conte91/MakeMeFly/README.md

This is a Programmable magnetic levitation project for my Electronics for embedded system course @Polythecnic University of Torino.

Follow my blog http://tux4u.wordpress.com for news about the project!
