conte91/MakeMeFly/Report/report.tex

\documentclass{article}
\newcommand{\pre}[1]{\texttt{#1}}
\usepackage{pdfpages}
\usepackage{graphicx}
\begin{document}
\includepdf{Copertina}
\include{0-intro}
\include{1-control}
\include{2-ADC}
\include{3-Coil}
\include{4-mouse}
\include{5-Flash}
\include{6-software}
\include{7-power}
\include{8-conclusions}
\end{document}
