conte91/MakeMeFly/Report/Copertina.odt

Simone Baratta

Electronics for embedded systems

A.A. 2013/2014

Magnetic levitation with a single Hall-effect sensor

Politecnico di Torino

Sept. 2015
