conte91/MakeMeFly/Plotter/green-button.png

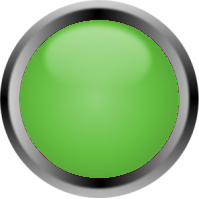
Plotter/green-button.png
