conte91/MakeMeFly/Plotter/red-button.png

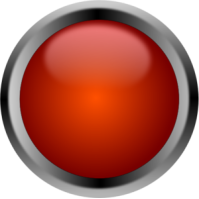
Plotter/red-button.png
