conte91/MakeMeFly/Report/Graphics/cpld_impl.png

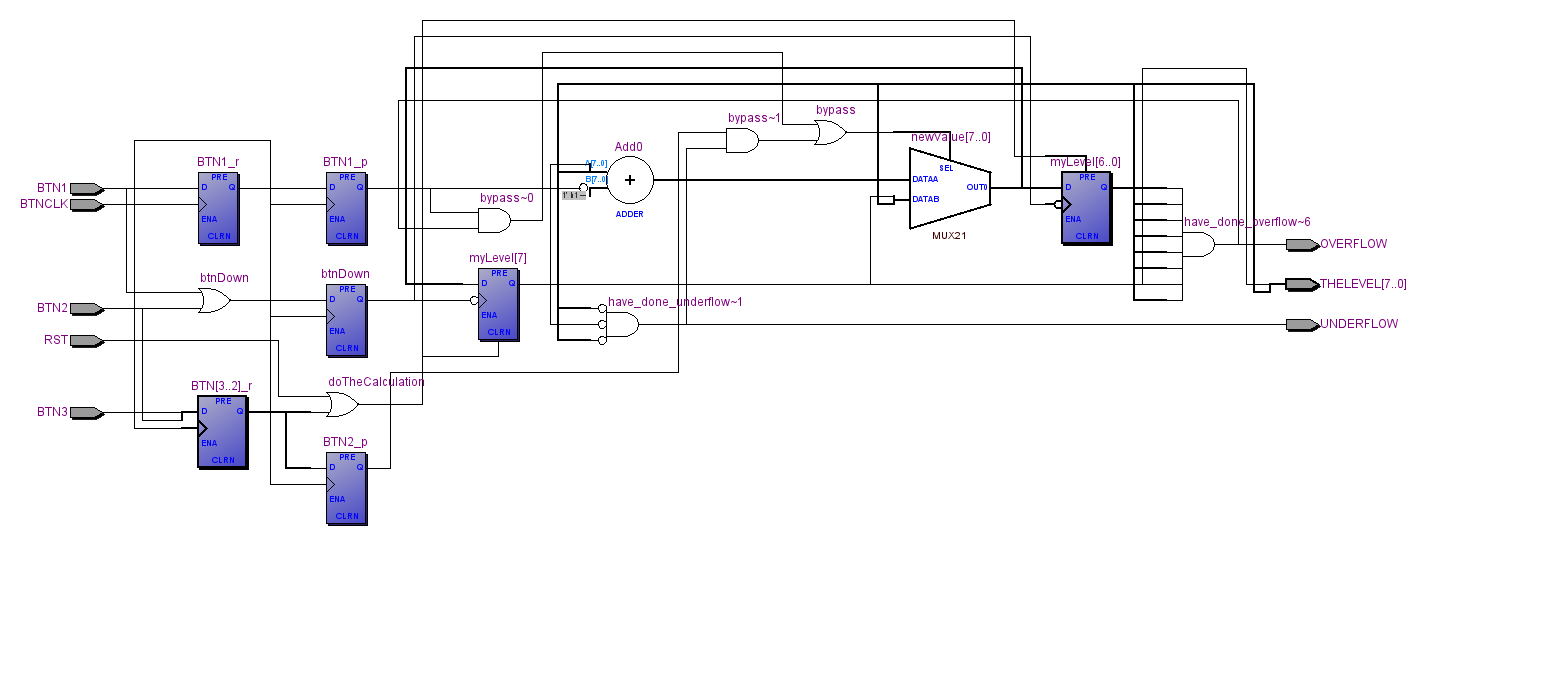
Report/Graphics/cpld_impl.png
