conte91/MakeMeFly/Plotter/test.pdf

### 5 mils 8 mils 12 mils 20 mils 35 mils 8 mils 12 mils 20 mils 35 mils

200 mils

10 sec | 15 sec | 20 sec | 25 sec | 30 sec | 40 sec | 50 sec | 60 sec | 80 sec | 100 sec | 120 sec | 150 sec | 180 sec | 240 sec
