conte91/MakeMeFly/Results/ADC_test/misctest.png

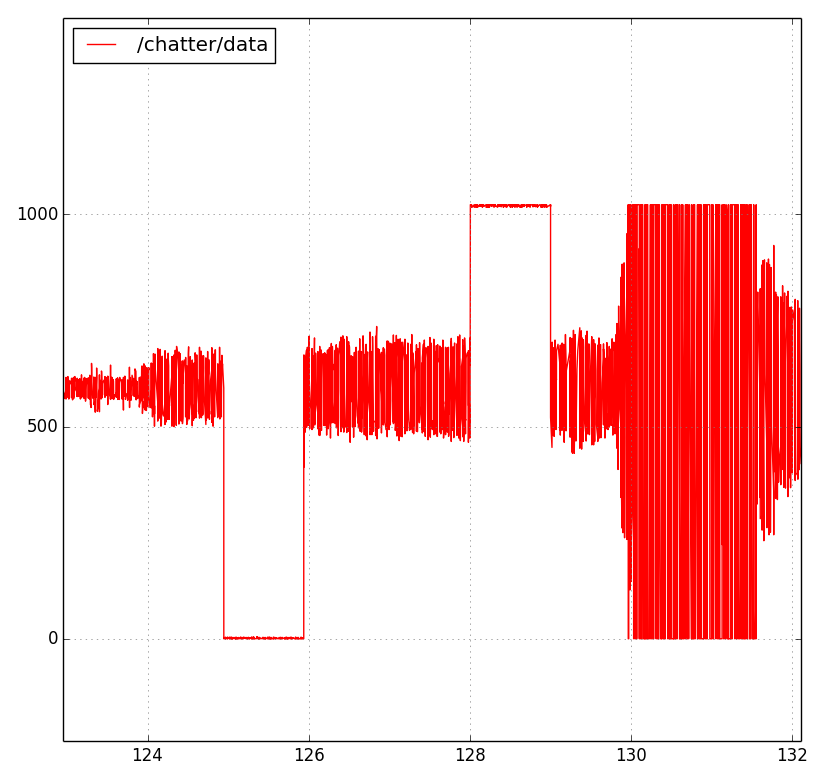
Results/ADC_test/misctest.png
