conte91/MakeMeFly/Results/ADC_test/whitenoise.png

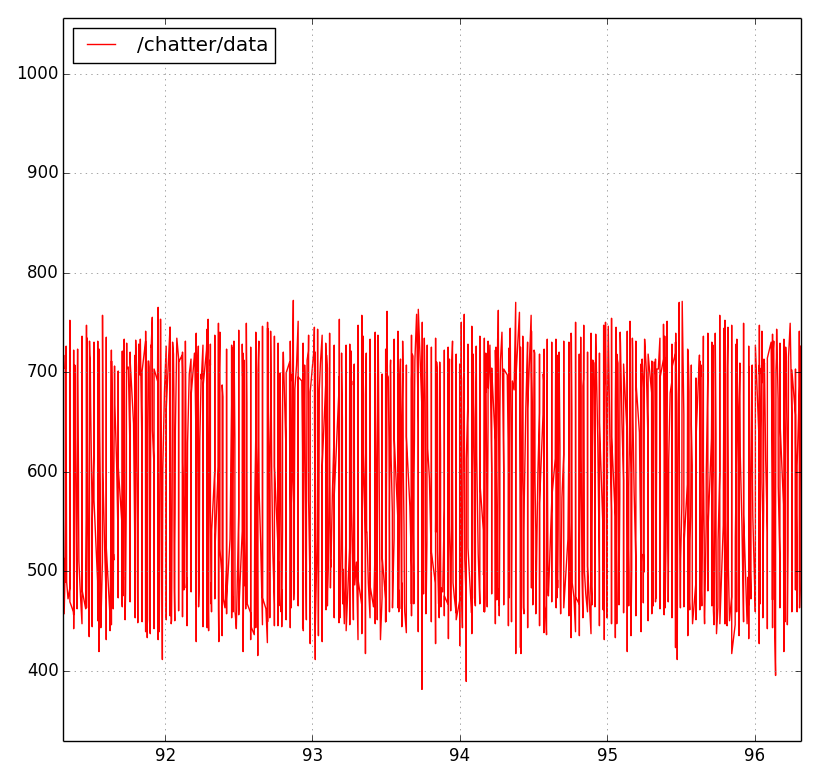
Results/ADC_test/whitenoise.png
