conte91/MakeMeFly/Schema/maglev.kicad_pcb

## KiCad design Schema/maglev.kicad_pcb (2015-09-15)

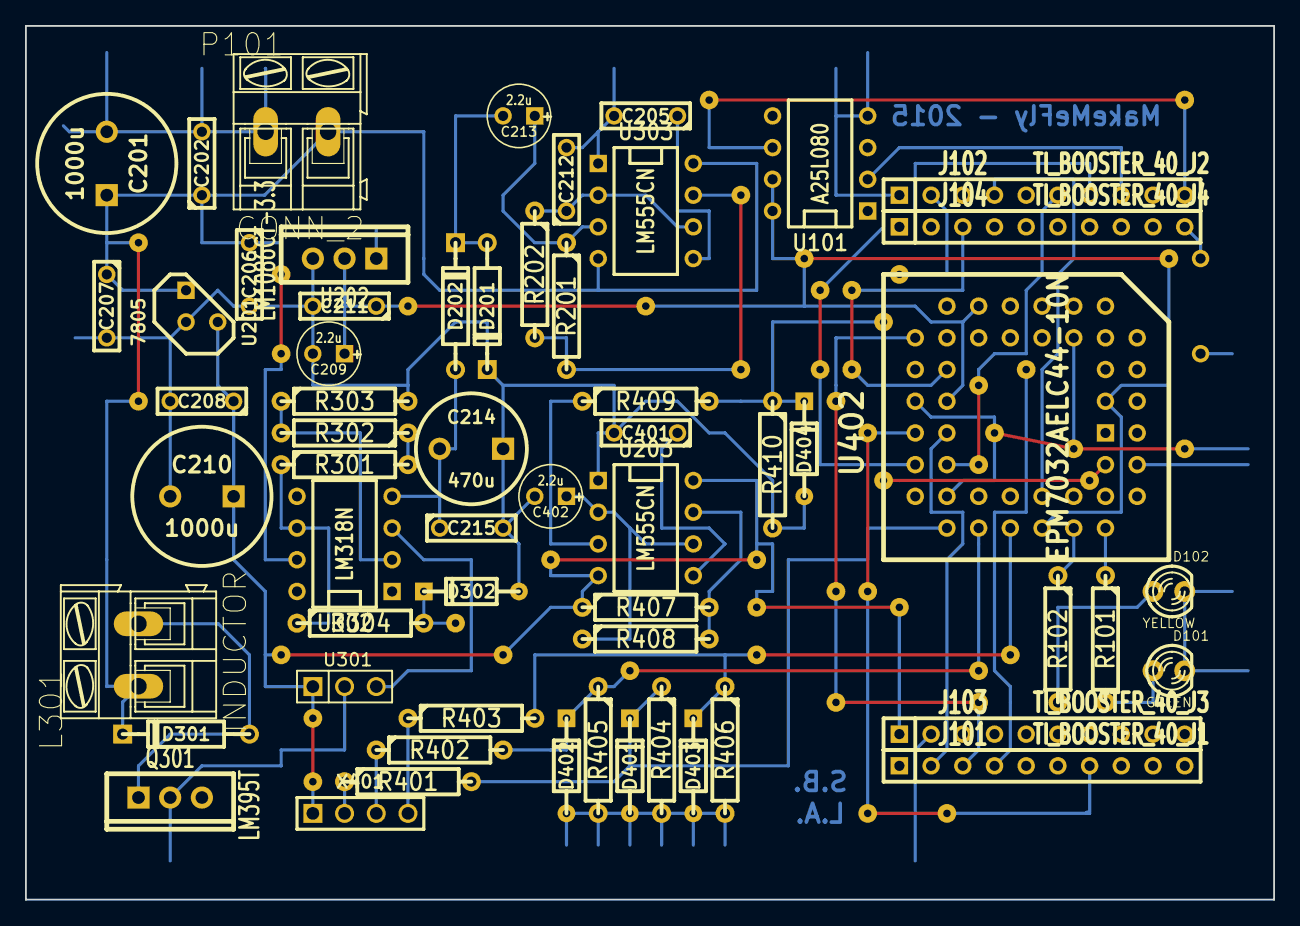
[picture p9: board maglev.kicad_pcb from above]

Board: 2 copper layers, 100.0 x 70.0 mm, 60 parts (1 on the bottom side), 47 nets.

Parts:
C201, C210: 1000u; C2V10
C202, C205, C206, C207, C208, C211, C215: 100n; C2
C209, C213, C402: 2.2u; C1V5
C212, C401: 4.7n; C2
C214: 470u; C2V8
D101: GREEN; LED-3MM
D102: YELLOW; LED-3MM
D201, D202, D301: 1N4007; DO-41
D302, D401, D402, D403, D404: 1N5226B; DO-35
J101: TI_BOOSTER_40_J1; SIL-10
J102: TI_BOOSTER_40_J2; SIL-10
J103: TI_BOOSTER_40_J3; SIL-10
J104: TI_BOOSTER_40_J4; SIL-10
L301: INDUCTOR; AK300-2
P101: CONN_2; AK300-2
Q301: LM395T; TO220_VERT_123
R101, R102, R304, R401, R402, R403, R409: 100; R4
R201: 3.3k; R4
R202, R303, R404, R405, R406, R408, R410: 10k; R4
R301, R302: 1k; R4
R407: 2.2k; R4
SW101: SW_PUSH; R3
U101: A25L080; DIP-8__300
U201: 7805; LM78XX-TO92
U202: LM1086CT-3.3; TO220_VERT_123
U203, U303: LM555CN; DIP-8__300
U301: SS495; PIN_ARRAY_3X1
U302: LM318N; DIP-8__300
U402: EPM7032AELC44-10N; PLCC44
X401: MOUSE_BUTTON_IF; PIN_ARRAY_4x1

Connections:
3.3V: C209.1, C211.1, U101.7, U101.8, U202.2, U402.3, U402.15, U402.23, U402.35
5V: C208.1, C210.1, J103.1, R407.1, U201.VO, U203.4, U203.8, U301.1, X401.1
12V: C201.1, C202.1, C206.1, C207.1, D301.2, L301.1, P101.2, U201.VI, U202.3, U302.7, U303.4, U303.8
-12V: C214.2, C215.1, D202.1, U302.4
/CS: J101.10, U101.1
/Mouse_input_control/D0: J101.3, U402.18
/Mouse_input_control/D1: J101.4, U402.19
/Mouse_input_control/D2: J102.2, U402.20
/Mouse_input_control/D3: J104.3, U402.21
/Mouse_input_control/D4: J101.7, U402.24
/Mouse_input_control/D5: J101.2, U402.25
/Mouse_input_control/D6: J102.7, U402.26
/Mouse_input_control/D7: J102.6, U402.27
/Mouse_input_control/OVERFLOW: R101.1, U402.39
/Mouse_input_control/RST: J102.4, U402.36
/Mouse_input_control/UNDERFLOW: R102.1, U402.37
B_SENSE: D302.2, J103.9, R304.2
GND: C201.2, C202.2, C205.2, C206.2, C207.2, C208.2, C209.2, C210.2, C211.2, C212.2, C214.1, C215.2, C401.2, C402.2, D101.2, D102.2, D201.2, D302.1, D401.1, D402.1, D403.1, D404.1, J102.1, J103.2, P101.1, Q301.2, R303.2, R404.2, R405.2, R406.2, R410.2, SW101.1, U101.4, U201.GND, U202.1, U203.1, U301.2, U303.1, U402.10, U402.22, U402.30, U402.42
MISO: J102.8, U101.2
MOSI: J101.8, U101.5
unnamed: J104.10, SW101.2
unnamed: D101.1, R101.2
unnamed: D102.1, R102.2
unnamed: C212.1, R202.1, U303.2, U303.6
unnamed: R201.2, R202.2, U303.7
unnamed: C213.2, D201.1, D202.2
unnamed: C213.1, R201.1, U303.3
unnamed: C205.1, U303.5
unnamed: R302.2, R303.1, U302.2
unnamed: R301.2, R302.1
unnamed: D301.1, L301.2, Q301.3
unnamed: U301.3, U302.3
unnamed: R301.1, R304.1, U302.6
unnamed: R403.1, X401.4
unnamed: C401.1, U203.5
unnamed: D403.2, R403.2, R406.1, U402.33
unnamed: D402.2, R402.2, R405.1, U402.31
unnamed: D401.2, R401.2, R404.1, U402.29
unnamed: R402.1, X401.3
unnamed: R401.1, X401.2
unnamed: C402.1, R408.1, U203.2, U203.6
unnamed: R409.1, U203.3
unnamed: D404.2, R409.2, R410.1, U402.43
unnamed: R407.2, R408.2, U203.7
PWR_OUT: J104.2, Q301.1
SPICLK: J102.10, U101.6
WEN: J101.9, U101.3
