conte91/MakeMeFly/Stellaris/ConstantField/startup_gcc.c

//*****************************************************************************
//
// startup_gcc.c - Startup code for use with GNU tools.
//
// Copyright (c) 2012 Texas Instruments Incorporated.  All rights reserved.
// Software License Agreement
// 
// Texas Instruments (TI) is supplying this software for use solely and
// exclusively on TI's microcontroller products. The software is owned by
// TI and/or its suppliers, and is protected under applicable copyright
// laws. You may not combine this software with "viral" open-source
// software in order to form a larger program.
// 
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
// This is part of revision 9453 of the EK-LM4F120XL Firmware Package.
//
//*****************************************************************************

#include "inc/hw_nvic.h"
#include "inc/hw_types.h"
#include <inc/hw_memmap.h>
#include <driverlib/gpio.h>
#include <driverlib/pin_map.h>
#include <driverlib/sysctl.h>
#include <driverlib/adc.h> 
#include <driverlib/uart.h>
#define DEFINE_VARIABLES
#include "variables.h"

//*****************************************************************************
//
// Forward declaration of the default fault handlers.
//
//*****************************************************************************
void ResetISR(void);
static void NmiSR(void);
static void FaultISR(void);
static void IntDefaultHandler(void);
static  void ADCHandler(void);
static  void Timer0BHandler(void);
static void UARTHandler(void);

//*****************************************************************************
//
// External declaration for the interrupt handler used by the application.
//
//*****************************************************************************
//extern void UARTIntHandler(void);

//*****************************************************************************
//
// The entry point for the application.
//
//*****************************************************************************
extern int main(void);

//*****************************************************************************
//
// Reserve space for the system stack.
//
//*****************************************************************************
static unsigned long pulStack[500];

//*****************************************************************************
//
// The vector table.  Note that the proper constructs must be placed on this to
// ensure that it ends up at physical address 0x0000.0000.
//
//*****************************************************************************
__attribute__ ((section(".isr_vector")))
void (* const g_pfnVectors[])(void) =
{
  (void (*)(void))((unsigned long)pulStack + sizeof(pulStack)),
  // The initial stack pointer
  ResetISR,                               // The reset handler
  NmiSR,                                  // The NMI handler
  FaultISR,                               // The hard fault handler
  IntDefaultHandler,                      // The MPU fault handler
  IntDefaultHandler,                      // The bus fault handler
  IntDefaultHandler,                      // The usage fault handler
  0,                                      // Reserved
  0,                                      // Reserved
  0,                                      // Reserved
  0,                                      // Reserved
  IntDefaultHandler,                      // SVCall handler
  IntDefaultHandler,                      // Debug monitor handler
  0,                                      // Reserved
  IntDefaultHandler,                      // The PendSV handler
  IntDefaultHandler,                      // The SysTick handler
  IntDefaultHandler,                      // GPIO Port A
  IntDefaultHandler,                      // GPIO Port B
  IntDefaultHandler,                      // GPIO Port C
  IntDefaultHandler,                      // GPIO Port D
  IntDefaultHandler,                      // GPIO Port E
  UARTHandler,                         // UART0 Rx and Tx
  IntDefaultHandler,                      // UART1 Rx and Tx
  IntDefaultHandler,                      // SSI0 Rx and Tx
  IntDefaultHandler,                      // I2C0 Master and Slave
  IntDefaultHandler,                      // PWM Fault
  IntDefaultHandler,                      // PWM Generator 0
  IntDefaultHandler,                      // PWM Generator 1
  IntDefaultHandler,                      // PWM Generator 2
  IntDefaultHandler,                      // Quadrature Encoder 0
  ADCHandler,                      // ADC Sequence 0
  ADCHandler,                      // ADC Sequence 1
  ADCHandler,                      // ADC Sequence 2
  ADCHandler,                      // ADC Sequence 3
  IntDefaultHandler,                      // Watchdog timer
  IntDefaultHandler,                      // Timer 0 subtimer A
  IntDefaultHandler,                      // Timer 0 subtimer B
  IntDefaultHandler,                      // Timer 1 subtimer A
  IntDefaultHandler,                      // Timer 1 subtimer B
  IntDefaultHandler,                      // Timer 2 subtimer A
  IntDefaultHandler,                      // Timer 2 subtimer B
  IntDefaultHandler,                      // Analog Comparator 0
  IntDefaultHandler,                      // Analog Comparator 1
  IntDefaultHandler,                      // Analog Comparator 2
  IntDefaultHandler,                      // System Control (PLL, OSC, BO)
  IntDefaultHandler,                      // FLASH Control
  IntDefaultHandler,                      // GPIO Port F
  IntDefaultHandler,                      // GPIO Port G
  IntDefaultHandler,                      // GPIO Port H
  IntDefaultHandler,                      // UART2 Rx and Tx
  IntDefaultHandler,                      // SSI1 Rx and Tx
  IntDefaultHandler,                      // Timer 3 subtimer A
  IntDefaultHandler,                      // Timer 3 subtimer B
  IntDefaultHandler,                      // I2C1 Master and Slave
  IntDefaultHandler,                      // Quadrature Encoder 1
  IntDefaultHandler,                      // CAN0
  IntDefaultHandler,                      // CAN1
  IntDefaultHandler,                      // CAN2
  IntDefaultHandler,                      // Ethernet
  IntDefaultHandler,                      // Hibernate
  IntDefaultHandler,                      // USB0
  IntDefaultHandler,                      // PWM Generator 3
  IntDefaultHandler,                      // uDMA Software Transfer
  IntDefaultHandler,                      // uDMA Error
  IntDefaultHandler,                      // ADC1 Sequence 0
  IntDefaultHandler,                      // ADC1 Sequence 1
  IntDefaultHandler,                      // ADC1 Sequence 2
  IntDefaultHandler,                      // ADC1 Sequence 3
  IntDefaultHandler,                      // I2S0
  IntDefaultHandler,                      // External Bus Interface 0
  IntDefaultHandler,                      // GPIO Port J
  IntDefaultHandler,                      // GPIO Port K
  IntDefaultHandler,                      // GPIO Port L
  IntDefaultHandler,                      // SSI2 Rx and Tx
  IntDefaultHandler,                      // SSI3 Rx and Tx
  IntDefaultHandler,                      // UART3 Rx and Tx
  IntDefaultHandler,                      // UART4 Rx and Tx
  IntDefaultHandler,                      // UART5 Rx and Tx
  IntDefaultHandler,                      // UART6 Rx and Tx
  IntDefaultHandler,                      // UART7 Rx and Tx
  0,                                      // Reserved
  0,                                      // Reserved
  0,                                      // Reserved
  0,                                      // Reserved
  IntDefaultHandler,                      // I2C2 Master and Slave
  IntDefaultHandler,                      // I2C3 Master and Slave
  IntDefaultHandler,                      // Timer 4 subtimer A
  IntDefaultHandler,                      // Timer 4 subtimer B
  0,                                      // Reserved
  0,                                      // Reserved
  0,                                      // Reserved
  0,                                      // Reserved
  0,                                      // Reserved
  0,                                      // Reserved
  0,                                      // Reserved
  0,                                      // Reserved
  0,                                      // Reserved
  0,                                      // Reserved
  0,                                      // Reserved
  0,                                      // Reserved
  0,                                      // Reserved
  0,                                      // Reserved
  0,                                      // Reserved
  0,                                      // Reserved
  0,                                      // Reserved
  0,                                      // Reserved
  0,                                      // Reserved
  0,                                      // Reserved
  IntDefaultHandler,                      // Timer 5 subtimer A
  IntDefaultHandler,                      // Timer 5 subtimer B
  IntDefaultHandler,                      // Wide Timer 0 subtimer A
  IntDefaultHandler,                      // Wide Timer 0 subtimer B
  IntDefaultHandler,                      // Wide Timer 1 subtimer A
  IntDefaultHandler,                      // Wide Timer 1 subtimer B
  IntDefaultHandler,                      // Wide Timer 2 subtimer A
  IntDefaultHandler,                      // Wide Timer 2 subtimer B
  IntDefaultHandler,                      // Wide Timer 3 subtimer A
  IntDefaultHandler,                      // Wide Timer 3 subtimer B
  IntDefaultHandler,                      // Wide Timer 4 subtimer A
  IntDefaultHandler,                      // Wide Timer 4 subtimer B
  IntDefaultHandler,                      // Wide Timer 5 subtimer A
  IntDefaultHandler,                      // Wide Timer 5 subtimer B
  IntDefaultHandler,                      // FPU
  IntDefaultHandler,                      // PECI 0
  IntDefaultHandler,                      // LPC 0
  IntDefaultHandler,                      // I2C4 Master and Slave
  IntDefaultHandler,                      // I2C5 Master and Slave
  IntDefaultHandler,                      // GPIO Port M
  IntDefaultHandler,                      // GPIO Port N
  IntDefaultHandler,                      // Quadrature Encoder 2
  IntDefaultHandler,                      // Fan 0
  0,                                      // Reserved
  IntDefaultHandler,                      // GPIO Port P (Summary or P0)
  IntDefaultHandler,                      // GPIO Port P1
  IntDefaultHandler,                      // GPIO Port P2
  IntDefaultHandler,                      // GPIO Port P3
  IntDefaultHandler,                      // GPIO Port P4
  IntDefaultHandler,                      // GPIO Port P5
  IntDefaultHandler,                      // GPIO Port P6
  IntDefaultHandler,                      // GPIO Port P7
  IntDefaultHandler,                      // GPIO Port Q (Summary or Q0)
  IntDefaultHandler,                      // GPIO Port Q1
  IntDefaultHandler,                      // GPIO Port Q2
  IntDefaultHandler,                      // GPIO Port Q3
  IntDefaultHandler,                      // GPIO Port Q4
  IntDefaultHandler,                      // GPIO Port Q5
  IntDefaultHandler,                      // GPIO Port Q6
  IntDefaultHandler,                      // GPIO Port Q7
  IntDefaultHandler,                      // GPIO Port R
  IntDefaultHandler,                      // GPIO Port S
  IntDefaultHandler,                      // PWM 1 Generator 0
  IntDefaultHandler,                      // PWM 1 Generator 1
  IntDefaultHandler,                      // PWM 1 Generator 2
  IntDefaultHandler,                      // PWM 1 Generator 3
  IntDefaultHandler                       // PWM 1 Fault
};

//*****************************************************************************
//
// The following are constructs created by the linker, indicating where the
// the "data" and "bss" segments reside in memory.  The initializers for the
// for the "data" segment resides immediately following the "text" segment.
//
//*****************************************************************************
extern unsigned long _etext;
extern unsigned long _data;
extern unsigned long _edata;
extern unsigned long _bss;
extern unsigned long _ebss;

//*****************************************************************************
//
// This is the code that gets called when the processor first starts execution
// following a reset event.  Only the absolutely necessary set is performed,
// after which the application supplied entry() routine is called.  Any fancy
// actions (such as making decisions based on the reset cause register, and
// resetting the bits in that register) are left solely in the hands of the
// application.
//
//*****************************************************************************
  void
ResetISR(void)
{
  unsigned long *pulSrc, *pulDest;

  //
  // Copy the data segment initializers from flash to SRAM.
  //
  pulSrc = &_etext;
  for(pulDest = &_data; pulDest < &_edata; )
  {
    *pulDest++ = *pulSrc++;
  }

  //
  // Zero fill the bss segment.
  //
  __asm("    ldr     r0, =_bss\n"
      "    ldr     r1, =_ebss\n"
      "    mov     r2, #0\n"
      "    .thumb_func\n"
      "zero_loop:\n"
      "        cmp     r0, r1\n"
      "        it      lt\n"
      "        strlt   r2, [r0], #4\n"
      "        blt     zero_loop");

  //
  // Enable the floating-point unit.  This must be done here to handle the
  // case where main() uses floating-point and the function prologue saves
  // floating-point registers (which will fault if floating-point is not
  // enabled).  Any configuration of the floating-point unit using DriverLib
  // APIs must be done here prior to the floating-point unit being enabled.
  //
  // Note that this does not use DriverLib since it might not be included in
  // this project.
  //
  HWREG(NVIC_CPAC) = ((HWREG(NVIC_CPAC) &
        ~(NVIC_CPAC_CP10_M | NVIC_CPAC_CP11_M)) |
      NVIC_CPAC_CP10_FULL | NVIC_CPAC_CP11_FULL);

  //
  // Call the application's entry point.
  //
  main();
}

//*****************************************************************************
//
// This is the code that gets called when the processor receives a NMI.  This
// simply enters an infinite loop, preserving the system state for examination
// by a debugger.
//
//*****************************************************************************
  static void
NmiSR(void)
{
  //
  // Enter an infinite loop.
  //
  while(1)
  {
  }
}

//*****************************************************************************
//
// This is the code that gets called when the processor receives a fault
// interrupt.  This simply enters an infinite loop, preserving the system state
// for examination by a debugger.
//
//*****************************************************************************
  static void
FaultISR(void)
{
  //
  // Enter an infinite loop.
  //
  GPIOPinWrite(GPIO_PORTF_BASE, GPIO_PIN_2, 0);
  while(1)
  {
  }
}

//*****************************************************************************
//
// This is the code that gets called when the processor receives an unexpected
// interrupt.  This simply enters an infinite loop, preserving the system state
// for examination by a debugger.
//
//*****************************************************************************
  static void
IntDefaultHandler(void)
{
  //
  // Go into an infinite loop.
  //
  while(1)
  {
  }
}

void ADCHandler(void){
  iMustDoTheControl=1;
  unsigned long ulADC0Value[1];
  ADCSequenceDataGet(ADC0_BASE, 0, ulADC0Value);
  lastADC=ulADC0Value[0];
  B = -(lastADC-BMin);
  ADCIntClear(ADC0_BASE,0);
}


void UARTHandler(void){
  char x =UARTCharGet(UART0_BASE);
  switch(x){
    case 'G':
      gainPos+=0.0001;
      break;
    case 'g':
      gainPos-=0.0001;
      break;
    case 'p':
      gainBase-=0.001;
      break;
    case 'P':
      gainBase+=0.001;
      break;
    case 's':
      squareWave=!squareWave;
      break;
    case 'd':
      downRate-=0.0001;
      break;
    case 'D':
      downRate+=0.0001;
      break;
    case 'u':
      upRate-=0.0001;
      break;
    case 'U':
      upRate+=0.0001;
      break;
    case 'o':
      outputDown=!outputDown;
      break;
    case 'O':
      outputUp=!outputUp;
      break;
    case 'W':
      mustWriteData=1;
      break;
  }
}
