conte91/MakeMeFly/(commit log)

2014-03-23 First ADC test
2015-08-22 PWM test to check sensor readings for different magnetic fields
2015-08-31 Stellaris wins, Magnet floats!!
2015-09-07 Tanti giorni di lavoro andati a buon fine :)
    [MouseWheelHandler.vhd.cfg, coil_model.sch]
2015-09-15 Sure it works now :)
    [Supply.sch, coilControl.sch, maglev.kicad_pcb, maglev.sch, mouseControl.sch, mouseModel.sch]
2015-09-15 Fix and optimize CPLD architecture - RTL wins, behavioural loses
    [MouseWheelHandler.vhd, MouseWheelHandlerTB.vhd]
2015-09-15 Add some informations about CPLD and more details on power DAC output
